jandromandro/Aquaponics/README.md

# Aquaponics
Code for my senior design capstone project.
